jstanley0/headlamp/headlamp-pcb/headlamp-pcb.kicad_pcb

## KiCad design headlamp-pcb/headlamp-pcb.kicad_pcb (2022-09-08)

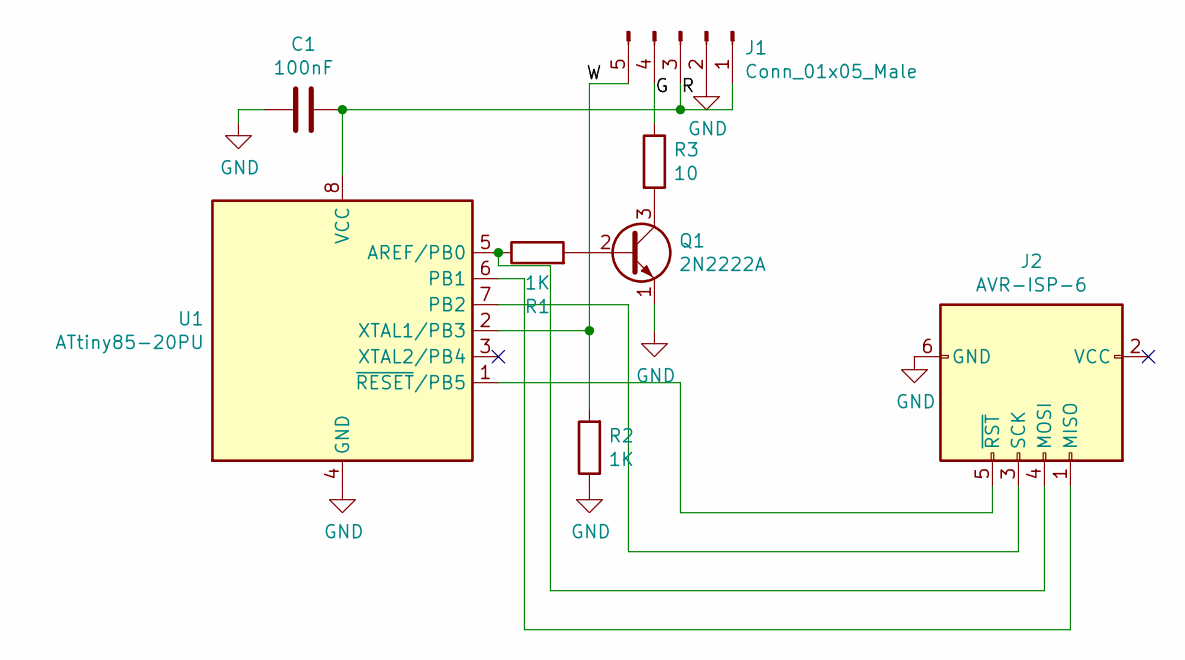
[picture p1: schematic headlamp-pcb.sch]

Parts:
C1: 100nF; C_Disc_D3.4mm_W2.1mm_P2.50mm
J1: Conn_01x05_Male; PinHeader_1x05_P2.54mm_Vertical
J2: AVR-ISP-6; PinHeader_2x03_P2.54mm_Vertical
Q1: 2N2222A; TO-92_Inline_Wide
R1, R2: 1K; R_Axial_DIN0204_L3.6mm_D1.6mm_P2.54mm_Vertical
R3: 10; R_Axial_DIN0204_L3.6mm_D1.6mm_P2.54mm_Vertical
U1: ATtiny85-20PU; DIP-8_W7.62mm

Connections:
/G: J1.4, R3.1
/R: C1.1, J1.1, J1.3, U1.8 (VCC)
/W: J1.5, R2.2, U1.2 (XTAL1/PB3)
GND: C1.2, J1.2, J2.6 (GND), Q1.1 (E), R2.1, U1.4 (GND)
unnamed: J2.1 (MISO), U1.6 (PB1)
unnamed: J2.3 (SCK), U1.7 (PB2)
unnamed: J2.4 (MOSI), R1.1, U1.5 (AREF/PB0)
unnamed: J2.5 (~RST), U1.1 (~RESET~/PB5)
unnamed: Q1.2 (B), R1.2
unnamed: Q1.3 (C), R3.2

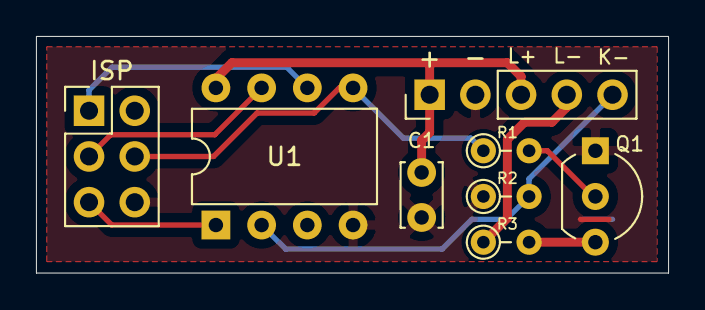
[picture p2: board headlamp-pcb.kicad_pcb from above]

Board: 2 copper layers, 35.1 x 13.1 mm, 8 parts (0 on the bottom side), 10 nets.
