jstanley0/headlamp/pwm.c

#include <avr/io.h>
#include "io.h"
#include "pwm.h"
#include "sync_sleep.h"

void pwm_on()
{
    OCR0A = 0;
    TCCR0A = (1 << COM0A1) | (1 << WGM00) | (1 << WGM01); // non-inverting fast PWM mode 3
    TCCR0B = (1 << CS00); // 1/8 prescaler
}

void pwm_off()
{
    TCCR0B = 0;
    PORTB &= ~(1 << LED_PORT);
}

static const uint8_t BRIGHTTABLE[] = {1, 6, 40, 255};

void fade(int8_t from, int8_t to)
{
    uint8_t b = BRIGHTTABLE[from], e = BRIGHTTABLE[to];
    int8_t s = (to == 3 || from == 3) ? 3 : 1;
    if (b < e) {
        for(; b <= e - s; b += s) {
            OCR0A = b;
            sync_sleep(1);
        }
    } else if (b > e) {
        for(; b >= e + s; b -= s) {
            OCR0A = b;
            sync_sleep(1);
        }
    }
    OCR0A = e;
}
