jstanley0/headlamp/(commit log)

2022-09-04 initial commit
    this is still thoroughly broken but it does prove some concepts
    things to fix:
    - it starts in LOW, not OFF, and I don't know why
    - holding the button to power off works, except that releasing
    the button wakes it up again and I don't know why
    - the fade functionality is thoroughly broken (and blocks I/O
    while fading)
    [button.c, main.c, pwm.c, sync_sleep.c]
2022-09-05 fix poweroff issue
    turns out there is an important difference between sleep_mode()
    and sleep_cpu(). sync_sleep() used the former and this cleared
    the sleep enable bit and prevented the latter from working again.
    so just use sleep_mode() everywhere
    also fix double-input on wakeup, which is probably why we never
    saw low-brightness mode before
    [button.c, main.c]
2022-09-06 fix hold issue
    the bug was hold time was cumulative for holds not long enough
    to meet the threshold. need to reset the hold counter. the dumb
    thing is I have fixed this bug before in other avr projects :P
    [button.c]
2022-09-06 remove pwm "off" state
    0 isn't off; we can't get a full off without using inverting
    fast PWM mode, but we have no reason to have the light off
    without powering down the micro
    also we can't fade between off and minimum, because it's
    literally the minimum duty cycle
    so just use 0-3 to mean low, med, hi, zomgblinding and drop
    the pretense of having the micro on with the light off
    [main.c, pwm.c]
2022-09-06 increase PWM refresh rate
    it was 61Hz (1MHz / 256 / 64) but this was visually noticeable
    since we're on hardware PWM there's probably no reason not to
    just drop the timer clock divider to 1/8 (which gets us 488Hz)
2022-09-07 prevent spurious power-on events
    I found that simply taking the headlamp off my head generates
    a pin-change interrupt pretty consistently. turn off headlamp,
    take it off my head, and it immediately turns itself back on.
    whoops.
    static electricity from my hair maybe? 10K pulldown resistor
    not sufficient? come to think of it, the circuit this replaces
    uses a 1K pulldown. they may be bad at UX design but they probably
    know some things I don't about electrical engineering. if I do
    a future hardware revision, I'll consider a change...
    ... but for now, just checking that the button is pressed over a
    15ms period after pin-change interrupt (and going back to sleep
    if it's not) totally fixes the pr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
    [button.c, main.c]
2022-09-07 power off after 20 minutes of inactivity
    the spurious power-on events (that the last commit seems to have
    solved) make me worry about this thing killing itself in my bag.
    so I decided to make it power down after 20 minutes with no
    button presses.
    this jibes with my use case (short bursts of a red light while
    switching eyepieces or changing lenses) but if you use this
    firmware for night trail runs, you'll probably want a much longer
    timeout
    [main.c]
2022-09-08 add schematic and PCB
    [headlamp-pcb.kicad_pcb, headlamp-pcb.sch]
